nva1773/Car-Battery-Charger/README.md

<h2 align="center">Зарядное устройство для кислотных аккумуляторов с функцией десульфатации.</h2>

### Папки и файлы:

    Firmware   файл с прошивкой микроконтроллера.
    Hard       Электронные схемы и печатные платы для PCAD, а также файлы для печати в формате pdf.
    Pictures   Фото сделанные по мере изготовления устройства.
    Soft       Проект для MPLAB IDE V8, написан на СИ и скомпилирован с помощью MPLAB C18 V3.
    README.md  Этот файл.
    
### Описание:

Зарядное устройство предназначено для заряда свинцово-кислотных аккумуляторов с напряжением 12В.

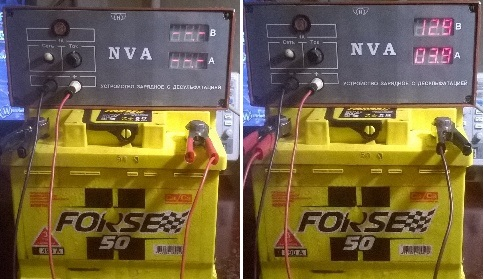
[picture p1: Pictures/4.jpg]
Внешний вид


Функция восстановления батареи (десульфатирования) реализована подачей заряда-разряда в импульсном режиме,
в соотношении тока 10:1 с временным интервалом 1:2.

Устройство обеспечивает плавную регулировку зарядного тока, снабжено индикаторами напряжения на батарее и тока зарядки.

Так же имеется защита от коротких замыканий на выходных зажимах и неправильной полярности подключения к батарее.

### Характеристики:

- питание от сети 220В/50Гц
- заряд свинцово-кислотных АКБ с напряжением 12V
- индикация напряжения на батарее
- индикация зарядного тока
- плавная регулировка зарядного тока от 1 до 5А
- стабилизация зарядного тока
- защита от переполюсовки и внешних коротких замыканий

### Наладка:

В режиме наладки можно проверить работоспособность узлов устройства, произвести их калибровку и настройку параметров.

Особенности:

- для активации функции наладки установите перемычку JP1 на плате управления
- перебор параметров производится кратковременным нажатие кнопки SA1
- сохранение параметра в EEPROM - нажатие и удержание кнопки SA1 более 3 секунд
- в верхнем индикаторе отображается параметр, в нижнем его номер

Параметры:

1. Проверка цепей измерения напряжения.

   **Цепи заряда и разряда отключены.**

   На клеммы падаем тестовое напряжение и резистором RV2 подстроить значение по образцовому прибору.

2. Проверка цепей измерения уставки тока заряда, резистор RV1.
   
   **Цепи заряда и разряда отключены.**
   
   В зависимости от положение резистора RV1 на индикаторе отображается значение от 1 до 41. 
   
   Т.е. имеем 40 шагов на весь диапазон регулятора.

3. Калибровка минимального тока заряда.

   **Цепь заряда включена, разряд отключен.**
   
   Подключаем к клеммам аккумулятор или реостат (например 6 Ом / 5 А) последовательно с образцовым амперметром.
   
   Резистором RV3 необходимо подстроить коэффициент  операционного уселителя, чтобы показания тока соответсвовали образцовому амперметру.
   
   Резистором RV1 устанавливаем 1А, нажимаем и удерживаем более 3 секунд кнопку SA1. При этом в EEPROM запоминается минимальный угол
   управления тиристором.
   
4. Калибровка максимального тока заряда.
   
   **Цепь заряда включена, разряд отключен.**
   
   Подключаем к клеммам аккумулятор или реостат последовательно с образцовым амперметром.
   
   Резистором RV1 устанавливаем 5А, нажимаем и удерживаем более 3 секунд кнопку SA1. При этом в EEPROM запоминается максимальный угол
   управления тиристором.
   
5. Проверка тока заряда.
   
   **Цепь заряда включена, разряд отключен.**
   
   Подключаем к клеммам аккумулятор или реостат.
   
   Если пункты 4 и 5 произведены правильно, то в зависимости от положения ручки резистора RV1, ток должен изменяться от 1А до 5А.

6. Проверка цепей разряда.
   
   **Цепь заряда отключена, разряд включен.**
   
   Подключаем к клемма последовательно амперметр и источник напряжения (12В) или аккумулятор.
   
   Вращая ручку резистора RV1 должны на амперметре наблюдать значения от -100 до -500 мА, т.е. 1:10 от тока заряда.
   
Для выхода из режима наладки необходимо снять перемычку JP1.

### Эксплуатация:

Подключите устройство к сети. Подайте питание выключателем SB1.

Ручкой регулятора установите необходимый ток заряда.

Если аккумулятор не подключен или перепутана полярности, то на индикаторах будет отображается прочерк (---).

Подключите аккумулятор к клеммам. Если аккумулятор разряжен процесс заряда начнется автоматически.

Когда напряжение достигнит 14,2В - заряд прекратится, на нижнем индикаторе будут отображается прочерки.

При снижении напряжения до 12,5В (саморазряд аккумулятора) процесс заряда повторится.

#### Процесс создания устройства можно посмотреть на этом [форуме](http://forum.easyelectronics.ru/viewtopic.php?f=17&t=30039).
