nva1773/Car-Battery-Charger/Hard/PDF/Faceplate.pdf

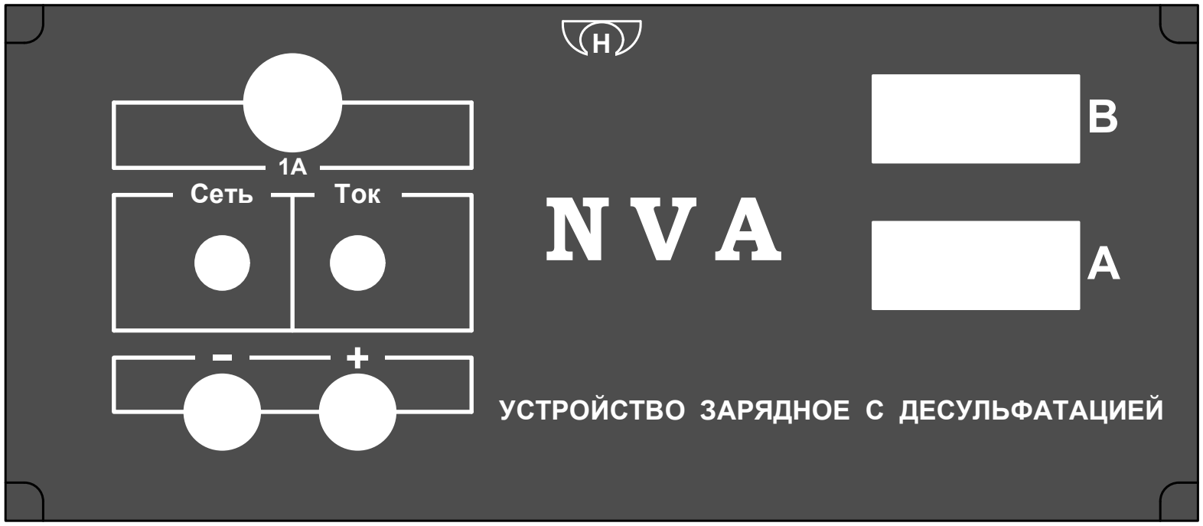
[picture p2: figure]
Сеть; Ток; УСТРОЙСТВО ЗАРЯДНОЕ С ДЕСУЛЬФАТАЦИЕЙ
