nva1773/Car-Battery-Charger/Pictures/1.jpg

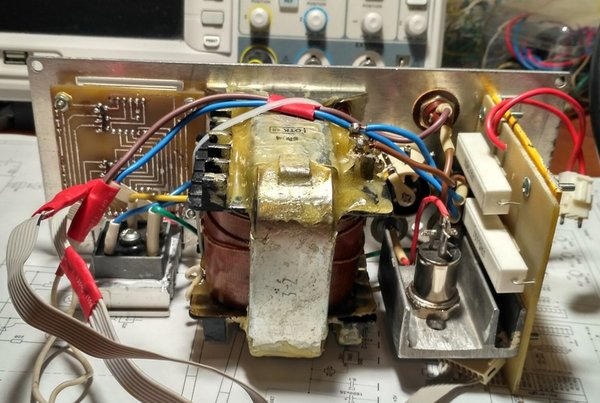
Pictures/1.jpg
