nva1773/Car-Battery-Charger/Pictures/2.jpg

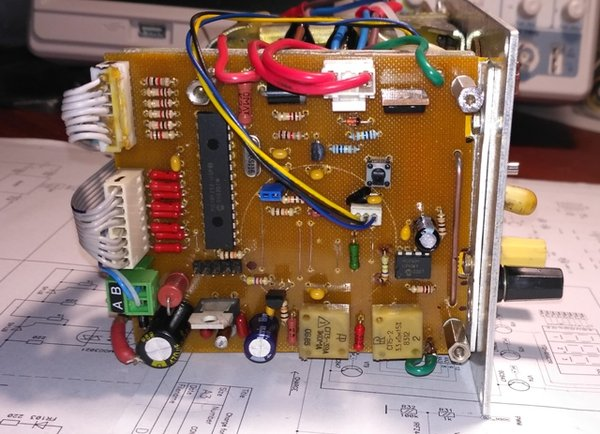
Pictures/2.jpg
