nva1773/Car-Battery-Charger/Pictures/3.jpg

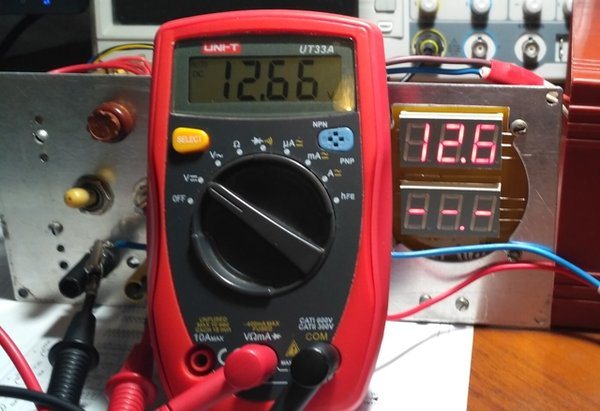
Pictures/3.jpg
