nva1773/Car-Battery-Charger/Hard/PDF/Display board bottom.pdf

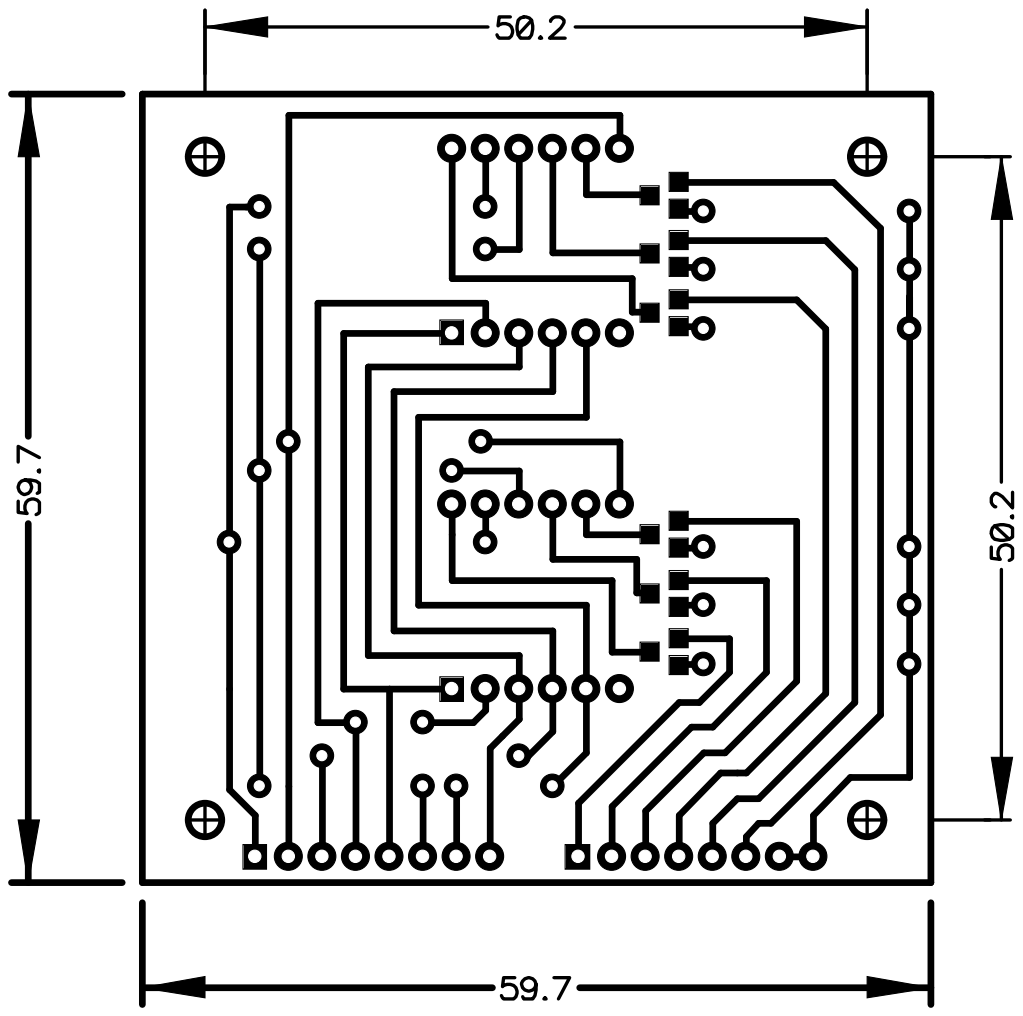
[picture p6: page 1]
