nva1773/Car-Battery-Charger/Hard/PDF/Display board top.pdf

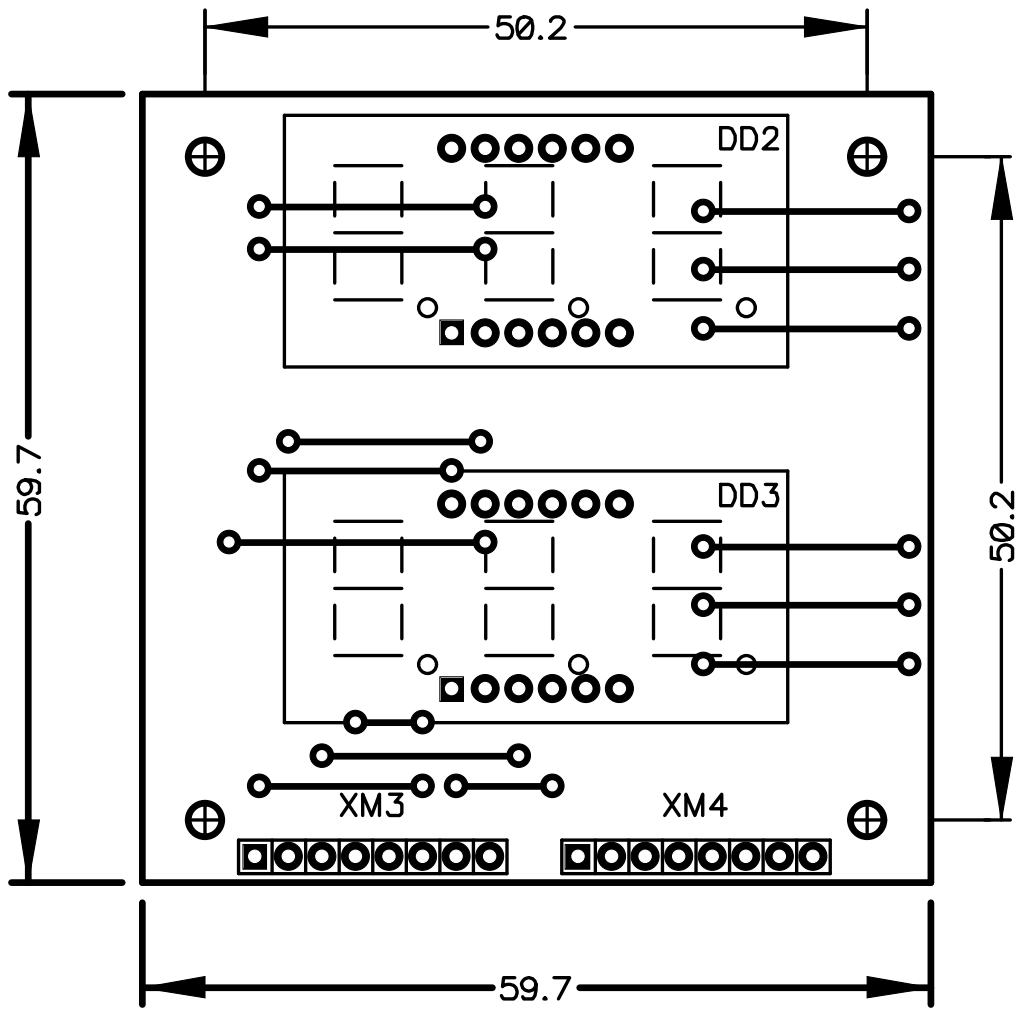
[picture p7: page 1]
