nva1773/Car-Battery-Charger/Hard/PDF/Control board bottom.pdf

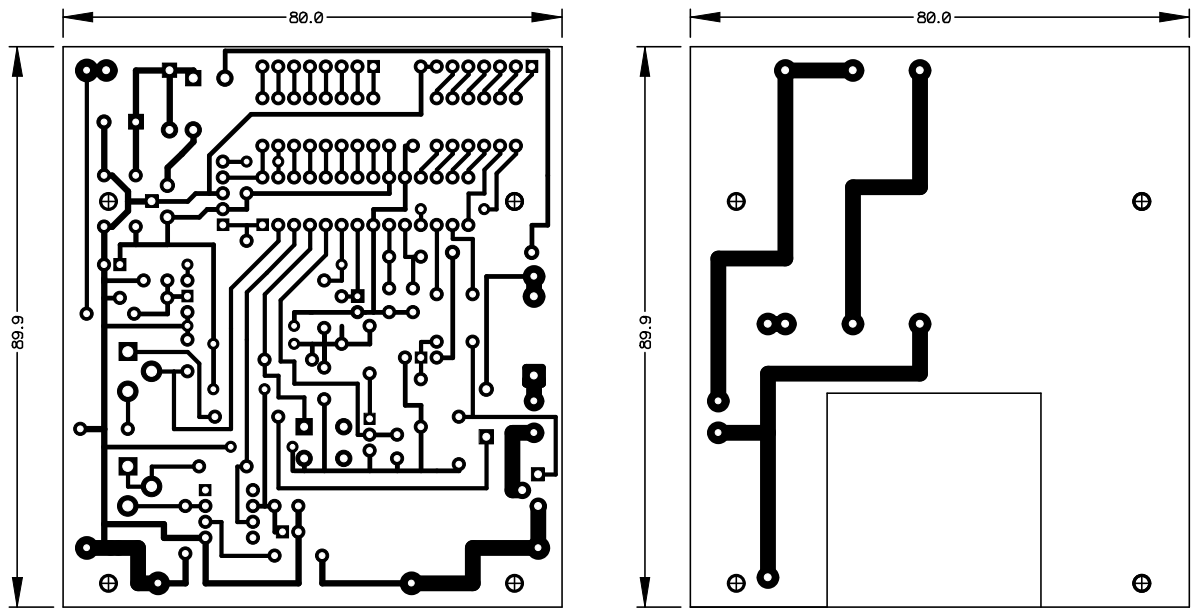
[picture p8: page 1]
