nva1773/Car-Battery-Charger/Hard/PDF/Control board top.pdf

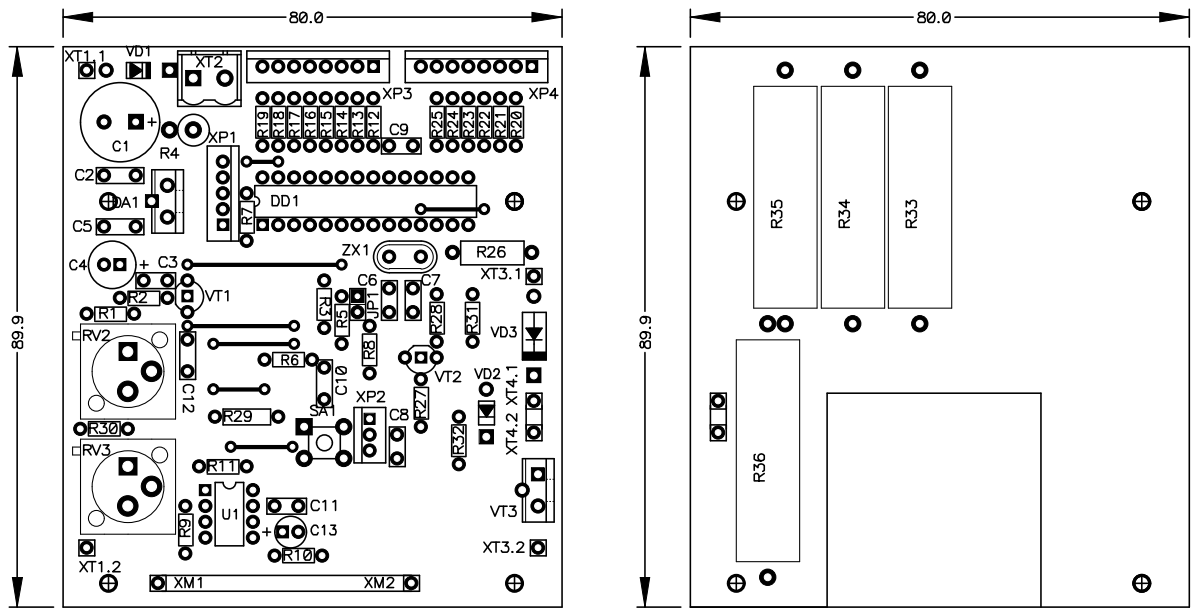
[picture p9: page 1]
