nva1773/Car-Battery-Charger/Hard/PDF/Control circuit.pdf

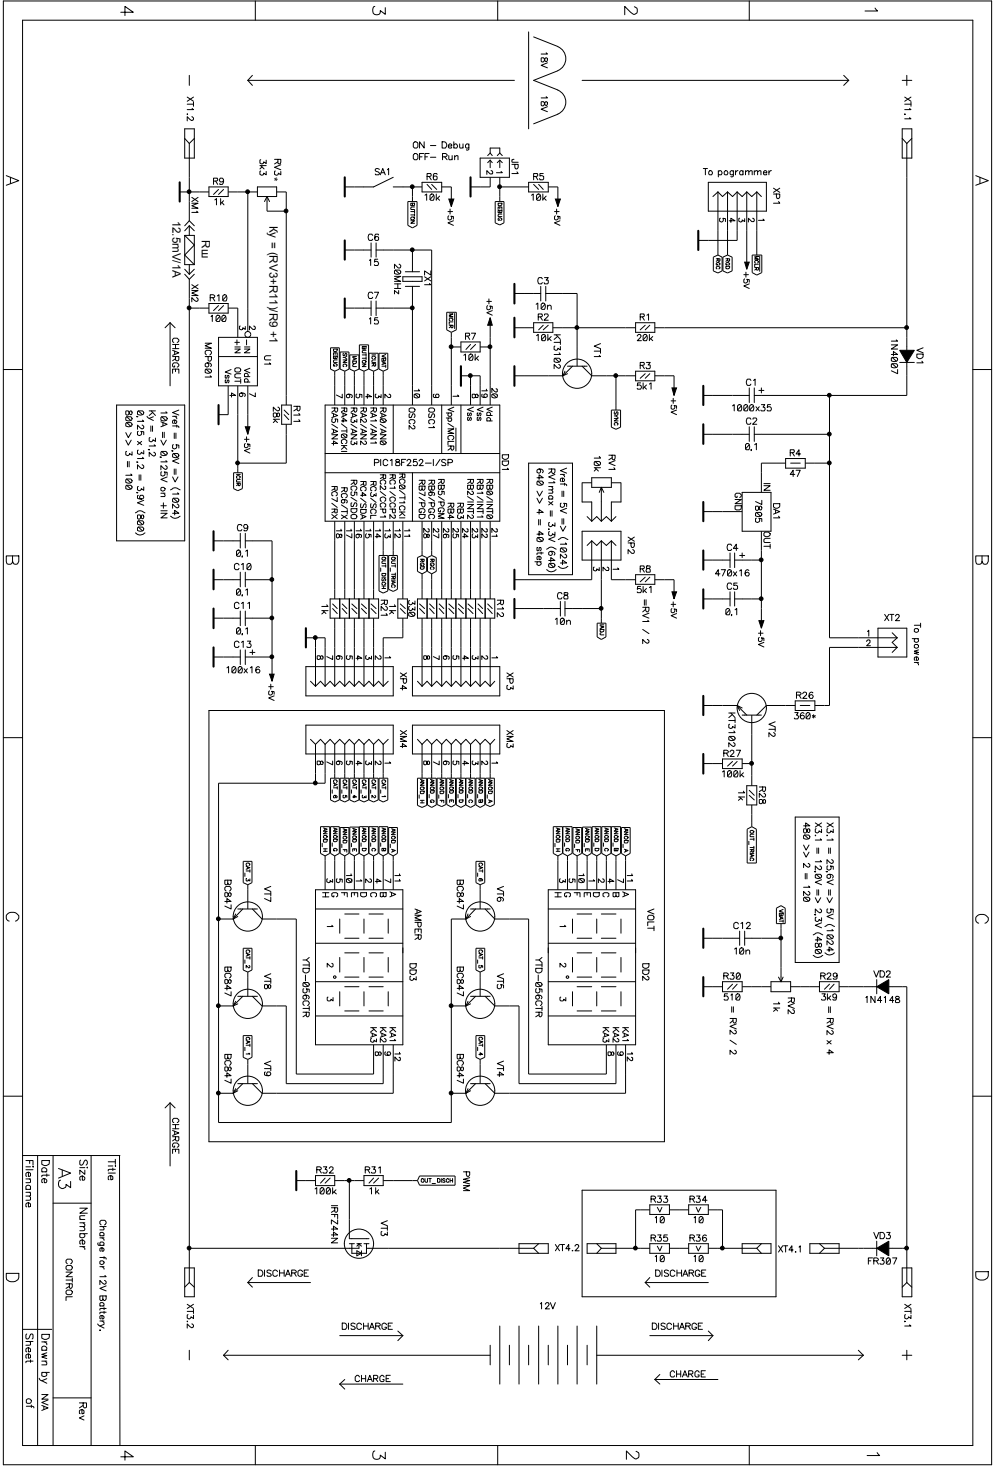
[picture p10: page 1]
