nva1773/Car-Battery-Charger/Hard/PDF/Power circuit.pdf

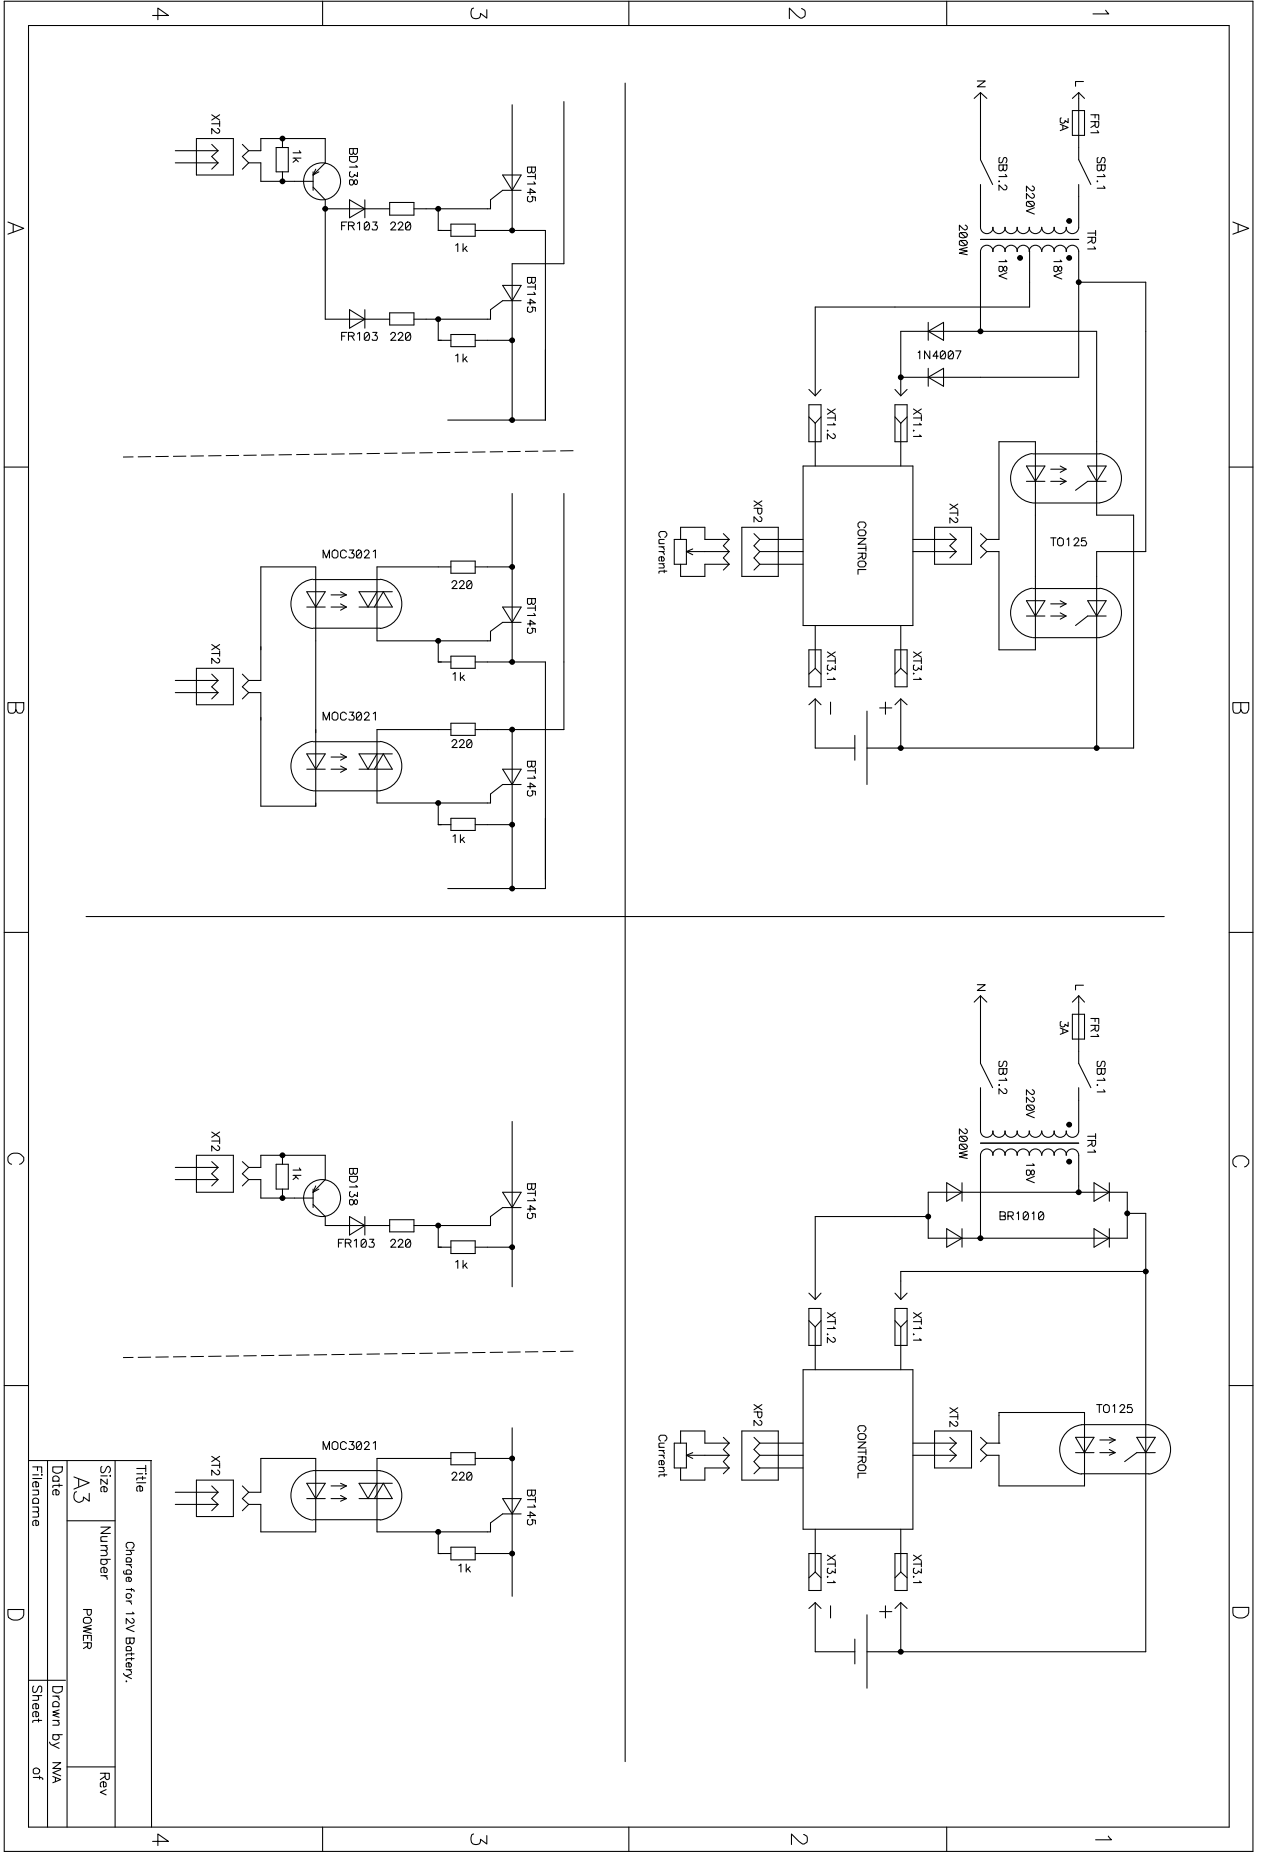
[picture p11: page 1]
