nva1773/Car-Battery-Charger/(list of files, drawings)

Other design files:
Hard/PCAD/Control.PCB
Hard/PCAD/Display.PCB
